WHyAMiHere-6/acoustic-sound-localization/Firmware/ESP32CAM.ino

#include <Arduino.h>
#include "esp_camera.h"
#include <WiFi.h>
#include <WebServer.h>

// ============================================================
// AI-THINKER ESP32-CAM PINOUT
// ============================================================

#define PWDN_GPIO_NUM     32
#define RESET_GPIO_NUM    -1
#define XCLK_GPIO_NUM      0
#define SIOD_GPIO_NUM     26
#define SIOC_GPIO_NUM     27

#define Y9_GPIO_NUM       35
#define Y8_GPIO_NUM       34
#define Y7_GPIO_NUM       39
#define Y6_GPIO_NUM       36
#define Y5_GPIO_NUM       21
#define Y4_GPIO_NUM       19
#define Y3_GPIO_NUM       18
#define Y2_GPIO_NUM        5

#define VSYNC_GPIO_NUM    25
#define HREF_GPIO_NUM     23
#define PCLK_GPIO_NUM     22

// ============================================================
// WIFI
// ============================================================

const char* ssid = "Google";
const char* password = "Abhay@6060";

WebServer server(80);

// ============================================================
// VIDEO PAGE
// ============================================================

void handleRoot()
{
  String page =
    "<!DOCTYPE html>"
    "<html>"
    "<head>"
    "<meta name='viewport' content='width=device-width,initial-scale=1'>"
    "<title>ESP32-CAM</title>"
    "<style>"
    "html,body{margin:0;background:#000;text-align:center;}"
    "img{width:100%;max-width:800px;height:auto;}"
    "</style>"
    "</head>"
    "<body>"
    "<img src='/stream'>"
    "</body>"
    "</html>";

  server.send(
    200,
    "text/html",
    page
  );
}

// ============================================================
// MJPEG STREAM
// ============================================================

void handleStream()
{
  WiFiClient client = server.client();

  client.print(
    "HTTP/1.1 200 OK\r\n"
    "Content-Type: multipart/x-mixed-replace; boundary=frame\r\n"
    "Cache-Control: no-cache\r\n"
    "Pragma: no-cache\r\n"
    "Connection: close\r\n\r\n"
  );

  while (client.connected())
  {
    camera_fb_t* fb = esp_camera_fb_get();

    if (!fb)
    {
      Serial.println("Camera capture failed");
      break;
    }

    client.print(
      "--frame\r\n"
      "Content-Type: image/jpeg\r\n"
      "Content-Length: "
    );

    client.print(fb->len);

    client.print(
      "\r\n\r\n"
    );

    client.write(
      fb->buf,
      fb->len
    );

    client.print(
      "\r\n"
    );

    esp_camera_fb_return(fb);

    // Small delay to prevent excessive CPU/network load
    delay(5);
  }
}

// ============================================================
// SETUP
// ============================================================

void setup()
{
  Serial.begin(115200);

  delay(1000);

  Serial.println();
  Serial.println("==============================");
  Serial.println("ESP32-CAM LOW LATENCY STREAM");
  Serial.println("==============================");


  // ==========================================================
  // CAMERA CONFIG
  // ==========================================================

  camera_config_t config;

  config.ledc_channel = LEDC_CHANNEL_0;
  config.ledc_timer = LEDC_TIMER_0;

  config.pin_d0 = Y2_GPIO_NUM;
  config.pin_d1 = Y3_GPIO_NUM;
  config.pin_d2 = Y4_GPIO_NUM;
  config.pin_d3 = Y5_GPIO_NUM;
  config.pin_d4 = Y6_GPIO_NUM;
  config.pin_d5 = Y7_GPIO_NUM;
  config.pin_d6 = Y8_GPIO_NUM;
  config.pin_d7 = Y9_GPIO_NUM;

  config.pin_xclk = XCLK_GPIO_NUM;
  config.pin_pclk = PCLK_GPIO_NUM;
  config.pin_vsync = VSYNC_GPIO_NUM;
  config.pin_href = HREF_GPIO_NUM;

  config.pin_sccb_sda = SIOD_GPIO_NUM;
  config.pin_sccb_scl = SIOC_GPIO_NUM;

  config.pin_pwdn = PWDN_GPIO_NUM;
  config.pin_reset = RESET_GPIO_NUM;

  config.xclk_freq_hz = 20000000;

  config.pixel_format = PIXFORMAT_JPEG;

  // ==========================================================
  // LOW LATENCY SETTINGS
  // ==========================================================

  config.frame_size = FRAMESIZE_QVGA;

  config.jpeg_quality = 15;

  config.fb_count = 2;

  config.grab_mode = CAMERA_GRAB_LATEST;

  if (psramFound())
  {
    config.fb_location = CAMERA_FB_IN_PSRAM;
  }
  else
  {
    config.fb_location = CAMERA_FB_IN_DRAM;
    config.fb_count = 1;
  }


  // ==========================================================
  // CAMERA INIT
  // ==========================================================

  Serial.println("Initializing camera...");

  esp_err_t err = esp_camera_init(&config);

  if (err != ESP_OK)
  {
    Serial.printf(
      "Camera init failed: 0x%x\n",
      err
    );

    while (true)
    {
      delay(1000);
    }
  }

  Serial.println("Camera OK");


  // ==========================================================
  // SENSOR SETTINGS
  // ==========================================================

  sensor_t* s = esp_camera_sensor_get();

  if (s)
  {
    s->set_framesize(
      s,
      FRAMESIZE_QVGA
    );

    s->set_quality(
      s,
      15
    );
  }


  // ==========================================================
  // WIFI
  // ==========================================================

  Serial.println("Connecting WiFi...");

  WiFi.begin(
    ssid,
    password
  );

  // Disable WiFi sleep for lower latency
  WiFi.setSleep(false);

  while (
    WiFi.status() != WL_CONNECTED
  )
  {
    delay(300);
    Serial.print(".");
  }

  Serial.println();

  Serial.println("WiFi connected");

  Serial.print(
    "IP: http://"
  );

  Serial.println(
    WiFi.localIP()
  );


  // ==========================================================
  // SERVER
  // ==========================================================

  server.on(
    "/",
    handleRoot
  );

  server.on(
    "/stream",
    handleStream
  );

  server.begin();

  Serial.println(
    "Video server started"
  );

  Serial.println();
  Serial.println(
    "Open the IP address above"
  );
}

// ============================================================
// LOOP
// ============================================================

void loop()
{
  server.handleClient();
}
