WHyAMiHere-6/acoustic-sound-localization/(commit log)

2026-11-02 Add ESP32CAM firmware file
2026-11-02 Revise README for clarity and add connection diagrams
    Updated terminology and improved clarity throughout the README. Added diagrams for ESP32 connections and clarified system architecture and performance metrics.
